666tong666/kuang/230/helmet_project/K230部署指南.md

# K230 部署指南 — YOLOv8 安全帽检测（CanMV IDE 版）

> 模型：`runs/helmet_yolov8n/weights/best.pt` (val mAP50=0.957, R=0.911, P=0.931, 3M 参数)
> 板端：Yahboom K230（CanMV micropython V1.4.3-3）
> 工具链：nncase 2.10.0 (KPU target) + Python 3.13 venv（`C:\Users\17244\.workbuddy\binaries\python\envs\default`）

---

## 1. 链路总览（全部已完成 ✅）

```
best.pt ──export_onnx.py──► best.onnx ──compile_kmodel.py──► helmet_yolov8n_uint8.kmodel
（已验证）                  (opset12, 1x3x640x640)           (3.5MB, PTQ uint8, NCHW 输入)
                                                                    │
                                                    拷到 SD 卡 /sdcard/ │
                                                                    ▼
                                              CanMV IDE 打开 helmet_inference.py
                                              点 ▶ 运行 → 实时检测（绿框=戴帽 红框=未戴）
```

PC 模拟验证已通过：6 张图 23 框，置信度 0.73~0.88，与 ONNX 基准一致（`verification/kmodel_sim/`）。

---

## 2. 你要做的事（CanMV IDE 用户，3 步）

### ① 拷 kmodel 到板子
任选其一：
- **U 盘方式（推荐）**：Type-C 线连板子和电脑 → 电脑出现 `CanMV` U 盘 → 把
  `D:\230\helmet_project\runs\helmet_yolov8n\kmodel\helmet_yolov8n_uint8.kmodel`
  拖进 U 盘（对应板端 `/sdcard/`）
- **读卡器方式**：拔 SD 卡插读卡器，把 kmodel 拷到卡根目录，插回板子

### ② CanMV IDE 打开脚本运行
1. 打开 CanMV IDE，左下角**连接**板子（选对应 COM 口）
2. 打开本地文件 `D:\230\helmet_project\helmet_inference.py`
3. 点左下角**绿色 ▶ 运行**
4. 看 IDE 右侧/上方**帧缓冲**面板：实时画面 + 检测框

### ③ 看效果
- 绿框 `helmet 0.xx` = 戴安全帽
- 红框 `head 0.xx` = 未戴帽
- 左上角 `helmet:N head:N fps:N` 实时统计
- 红色 ■ 停止

**没接屏幕？** 脚本默认 `DISPLAY_MODE="virt"`（只在 IDE 里预览），无需任何屏幕。
接了配套 MIPI 屏（ST7701 800×480）就改成 `"lcd"`；HDMI 屏改 `"hdmi"`。

---

## 2.5 串口输出人数（TTL 转 USB）

`helmet_inference.py` 已内置串口输出，每帧发一行（115200, 8N1）：

```
helmet:2,head:1\r\n     ← 戴帽人数 / 未戴帽人数
```

### 接线（3 根线，断电接）

| TTL 转 USB 模块 | K230 板 |
|---|---|
| RX | 板子 UART TX（TXD） |
| TX | 板子 UART RX（只发不收可不接） |
| GND | GND（**必须共地**） |
| VCC/5V | **不接** |

- 模块若有 5V/3.3V 跳线，选 **3.3V**；官方文档警告禁用劣质 CH340G 黄跳帽模块（可能烧 IO）
- 亚博板有专用串口排座的话直接用配套 PH2.0 线；脚本会**自动优先用亚博固件的
  `ybUtils.YbUart`**（自动处理引脚映射），找不到该库才回退 FPIOA 映射
  UART1（默认 pin11=TX / pin12=RX，可在脚本顶部 `UART_TX_PIN/UART_RX_PIN` 改）
- 引脚位置不确定时：跑一下脚本看启动日志 `[uart] ...` 用了哪种方式；或跑亚博官方
  「串口通信」基础例程看它用的引脚，把 `UART_TX_PIN/UART_RX_PIN` 改成一样的

### PC 端看数据（两种方式任选）

1. **串口助手**（SSCOM/XCOM 等）：选 TTL 模块的 COM 口，115200-8-N-1，ASCII 显示
2. **本项目脚本**（会实时打印每行人数）：
   ```bash
   D:/230/venv2/Scripts/python.exe uart_reader.py --list   # 插上模块后找新 COM 口
   D:/230/venv2/Scripts/python.exe uart_reader.py COM7     # 115200 默认
   ```

### 可调参数（脚本顶部配置区）

| 参数 | 默认 | 说明 |
|---|---|---|
| `UART_ENABLE` | `True` | 关掉串口输出 |
| `UART_BAUDRATE` | `115200` | 与 PC 端一致 |
| `UART_SEND_EVERY_FRAME` | `True` | `False`=人数变化时才发（串口更安静） |

### 接 STM32 主控（正式部署，替代 TTL 转 USB）

K230 的串口输出可直接接入主工程 `kuan/`（STM32F407VET6）的 **UART4**，
STM32 在接收中断里解析人数，随环境数据一起经蓝牙/MQTT 上报小程序：

| K230 板 | STM32F407VET6 | 说明 |
|---|---|---|
| UART TX（pin11 / TXD 排针） | **PC11**（UART4_RX） | 人数数据 K230 → STM32 |
| UART RX（pin12 / RXD 排针） | **PC10**（UART4_TX） | 只收不发可不接 |
| GND | GND | **必须共地** |

- 两侧都是 **3.3V 电平**，可直连，无需电平转换；
- STM32 侧固件已实现（`kuan/Driver/USART.c` 的 `UART4_Config` + 接收中断解析），
  K230 掉线超 5 秒 OLED 第 4 行右侧显示 `H:-U:-`；
- 上报格式见 `xiaocehngx/docs/STM32数据上报协议.md` v2.1（`helmet`/`head` 字段）。

---

## 3. 板端脚本说明（helmet_inference.py）

与嘉楠官方 yolov8n 检测示例完全同构（V1.4.x media API）：

- sensor 双通道：chn0 YUV420 绑显示层（AI 慢不卡预览），chn1 RGB888P(=NCHW) 给 AI
- ai2d 做 letterbox（等比缩放 + 右/下 pad 128）→ 640×640 NCHW uint8
- kmodel 内已烧入归一化（uint8→0~1），板端无需再算
- 后处理：阈值过滤 → **分类别 NMS**（helmet/head 互不抑制）→ 画框
- 输出 `[1,6,8400]`：4 框参数 + helmet/head 两类 sigmoid 分数

可调参数（脚本顶部配置区）：

| 参数 | 当前值 | 说明 |
|---|---|---|
| `DISPLAY_MODE` | `"virt"` | IDE 预览 / `"lcd"` / `"hdmi"` |
| `CONF_THRESH` | 0.30 | 怕漏检降到 0.25 |
| `NMS_THRESH` | 0.45 | YOLO 标配 |
| `LABELS` | `("helmet","head")` | **必须与训练 data.yaml 一致，勿改顺序** |

---

## 4. 如需重新编译 kmodel（换板型 / 重训后）

```bash
cd D:\230\helmet_project

# 校准集（已有 calib_data/ 可跳过）
"C:/Users/17244/.workbuddy/binaries/python/envs/default/Scripts/python.exe" ptq_calib.py --n 32

# 编译（K230；板型若是 K230D 加 --target k230d）
DOTNET_ROLL_FORWARD=Major "C:/Users/17244/.workbuddy/binaries/python/envs/default/Scripts/python.exe" \
  compile_kmodel.py --ptq calib_data --preprocess --input_shape 1,3,640,640 --input_layout NCHW

# PC 模拟质检（编译后必跑）
DOTNET_ROLL_FORWARD=Major "C:/Users/17244/.workbuddy/binaries/python/envs/default/Scripts/python.exe" \
  verify_kmodel.py
```

> **注意**：`--input_shape 1,3,640,640 --input_layout NCHW` 是板端部署的正确姿势
> （sensor RGBP888 + ai2d 输出就是 NCHW）。NHWC 版仅 PC 调试用。

## 5. 板型确认（K230 vs K230D）

CanMV IDE 连接后，在串口终端（REPL）执行：

```python
import chip
print(chip.name())
```

- 输出 `k230` → 当前 kmodel 直接用
- 输出 `k230d` → 用 `--target k230d` 重编（见上节）
- 报错没有 `chip` 模块 → 看板子丝印/说明书确认

---

## 6. 关键参数 / 经验值

| 参数 | 训练 | K230 部署 | 说明 |
|---|---|---|---|
| input shape | 640×640 | 640×640 | 静态输入，KPU 效率高 |
| input layout | NCHW float32 | **NCHW uint8**（preprocess=True） | 归一化烧进 kmodel |
| conf threshold | val 0.001 | **0.30**（可 0.25） | 安全帽宁可误报不能漏报 |
| NMS IoU | – | 0.45 | 分类别 NMS |
| labels | helmet=0, head=1 | 严格一致 | 反了"安全/危险"判断就反了 |

## 7. nncase 工具链踩坑记录（PC 侧）

| 坑 | 修复 |
|---|---|
| PyPI 的 nncase 不带 KPU 后端（`check_target('k230')=False`） | 用 kendryte 官方 wheel：`tools/nncase-2.10.0-*.whl` + `tools/nncase_kpu-2.10.0-*.whl`（手动解压覆盖到 site-packages） |
| nncase 硬绑 .NET 7，系统只有 .NET 8+ | 运行前设 `DOTNET_ROLL_FORWARD=Major` |
| venv3 的 cv2/numpy 被装坏 | 校准图用 PIL；numpy 重装 |
| GitHub release 直连超时 | 用嘉楠国内 CDN：`https://download.kendryte.com/developer/tools/nncase/v2.10.0/`（curl 会被沙盒截断，用 PowerShell Invoke-WebRequest） |
| nncase Simulator 报 DLL 找不到 | 把 site-packages 根目录加进 `PATH` + 设 `NNCASE_PLUGIN_PATH` |
| 预处理除两次 255（分数全死 ~0.0007） | `input_range=[0,1]` 时 `std` 必须 `[1,1,1]` |
| 校准张量缺 batch 维 | 每个样本包成 `[array]`，shape `[1,3,640,640]` |

---

## 8. 故障排查（板端）

| 现象 | 原因 / 处理 |
|---|---|
| `找不到 kmodel` | kmodel 不在 `/sdcard/`；确认 U 盘拷贝完成（3.5MB） |
| `kpu.load_kmodel` 报版本/格式错误 | kmodel(2.10 编译) 与固件 nncase 运行时不匹配 → 报我，用 2.9 重编一版 |
| `No available sensor` | 摄像头没插好或不在默认 CSI 口；脚本会自动试 `Sensor(id=2)`，还不行检查排线 |
| `ImportError: media.sensor` | 固件过老，需 CanMV V1.4.x media API（你的 V1.4.3 没问题） |
| 画面黑 / 无预览 | `DISPLAY_MODE` 不对；无屏用 `"virt"` |
| 画面上下颠倒 | 取消脚本里 `sensor.set_hmirror / set_vflip` 注释 |
| FPS 很低（<3） | 正常范围：640×640 uint8 在 K230 约 5~10 FPS；要更快用 320×320 重训 |
| 检测框位置飘 | 摄像头分辨率与 AI_W/AI_H 不符；或 `ratio` 相关参数被改动 |
| 长时间运行内存溢出 | 脚本已每帧 `gc.collect()`；仍出现则重启板子 |

---

## 9. 文件清单

| 文件 | 作用 |
|---|---|
| `runs/helmet_yolov8n/kmodel/helmet_yolov8n_uint8.kmodel` | **部署产物**（3.5MB，拷 SD 卡） |
| `helmet_inference.py` | 板端推理脚本（CanMV IDE 直跑，含串口人数输出） |
| `uart_reader.py` | PC 端读取串口人数（需 pyserial，venv2 已装） |
| `compile_kmodel.py` | ONNX → kmodel 编译（NCHW/NHWC 双模式） |
| `verify_kmodel.py` | PC 模拟质检 kmodel（喂 NCHW uint8） |
| `ptq_calib.py` | PTQ 校准集生成 |
| `export_onnx.py` | best.pt → best.onnx |
| `verification/kmodel_sim/` | kmodel 模拟验证结果图 |
| `tools/*.whl` | kendryte 官方 nncase wheel 备份 |
