666tong666/kuang/230/helmet_project/训练报告.md

# 安全帽检测 YOLOv8n 模型训练报告

## 任务
用 YOLOv8 训练一个轻量化模型，检测人员是否佩戴安全帽。

## 环境
- Python: D:\230\venv2 (Python 3.10.10)
- torch 2.3.0+cu121, ultralytics 8.4.105
- GPU: NVIDIA GeForce RTX 3060 Laptop (6GB)

## 数据集
- 来源: Kaggle `andrewmvd/hard-hat-detection`（Hard Hat Workers，工地场景）
- 5000 张图，VOC 标注转换为 YOLO 格式
- 划分: train 4250 / val 750
- 类别: 0=helmet(戴安全帽, 18966 框), 1=head(未戴, 5785 框)

## 训练配置
- 模型: YOLOv8n（300 万参数, 8.1 GFLOPs, 权重仅 6MB — 轻量化）
- epochs=60, imgsz=640, batch=16, GPU 训练 1.4 小时

## 最终验证指标（best.pt, 750 张验证集）
| 类别 | P | R | mAP50 | mAP50-95 |
|---|---|---|---|---|
| 全部 | 0.933 | 0.911 | **0.956** | 0.631 |
| helmet 戴帽 | 0.946 | 0.920 | 0.967 | 0.637 |
| head 未戴 | 0.915 | 0.903 | 0.944 | 0.624 |

- 推理速度: ~4.7ms/张 (GPU)

## 文件位置（D:\230\helmet_project\）
- `runs/helmet_yolov8n/weights/best.pt` — 最佳模型权重
- `runs/helmet_yolov8n/results.png` — 训练曲线
- `runs/helmet_yolov8n/confusion_matrix_normalized.png` — 混淆矩阵
- `demo/pred/image0-3.jpg` — 推理演示效果图
- `train.py` / `predict.py` / `data.yaml` / `convert_voc_to_yolo.py` — 全套脚本

## 使用方法
```bash
# 图片/视频/摄像头推理
D:/230/venv2/Scripts/python.exe predict.py --source 图片路径
# 摄像头: --source 0
```
