666tong666/kuang/230/helmet_project/demo/pred/image2.jpg

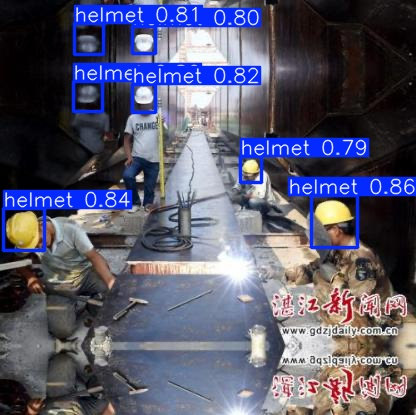
230/helmet_project/demo/pred/image2.jpg
