666tong666/kuang/230/helmet_project/runs/detect/val/BoxPR_curve.png

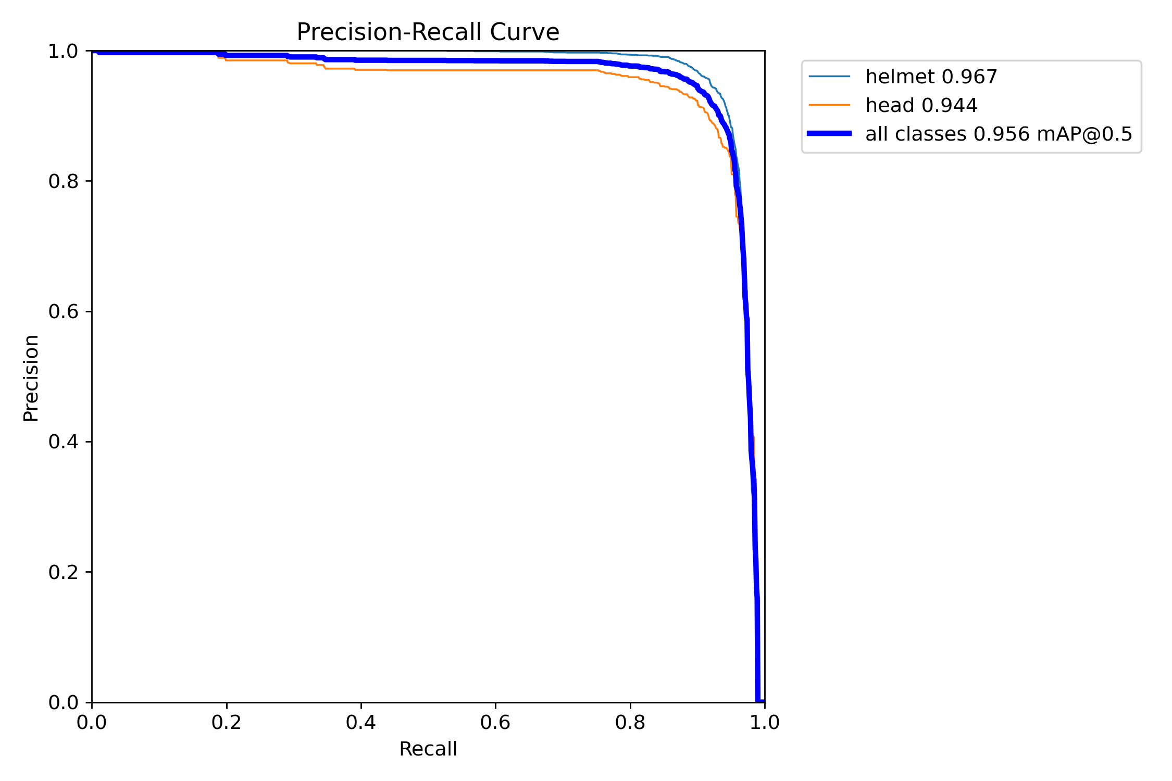
230/helmet_project/runs/detect/val/BoxPR_curve.png
