666tong666/kuang/230/helmet_project/runs/detect/val/BoxR_curve.png

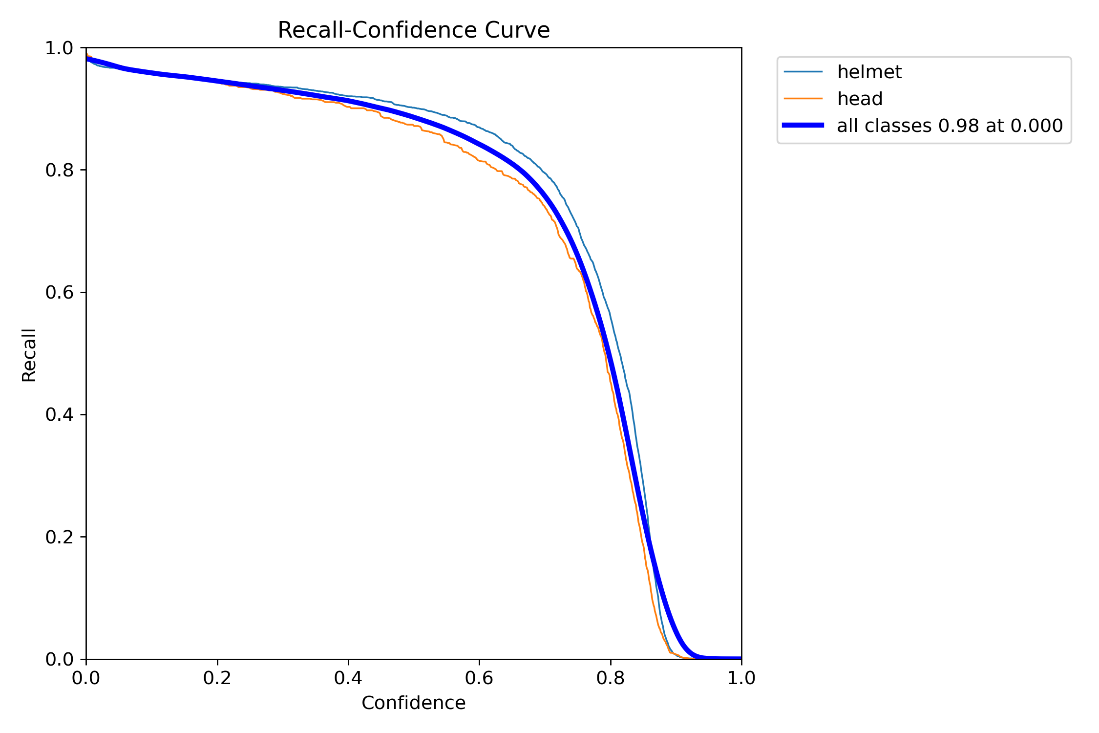
230/helmet_project/runs/detect/val/BoxR_curve.png
