666tong666/kuang/230/helmet_project/runs/detect/val/confusion_matrix.png

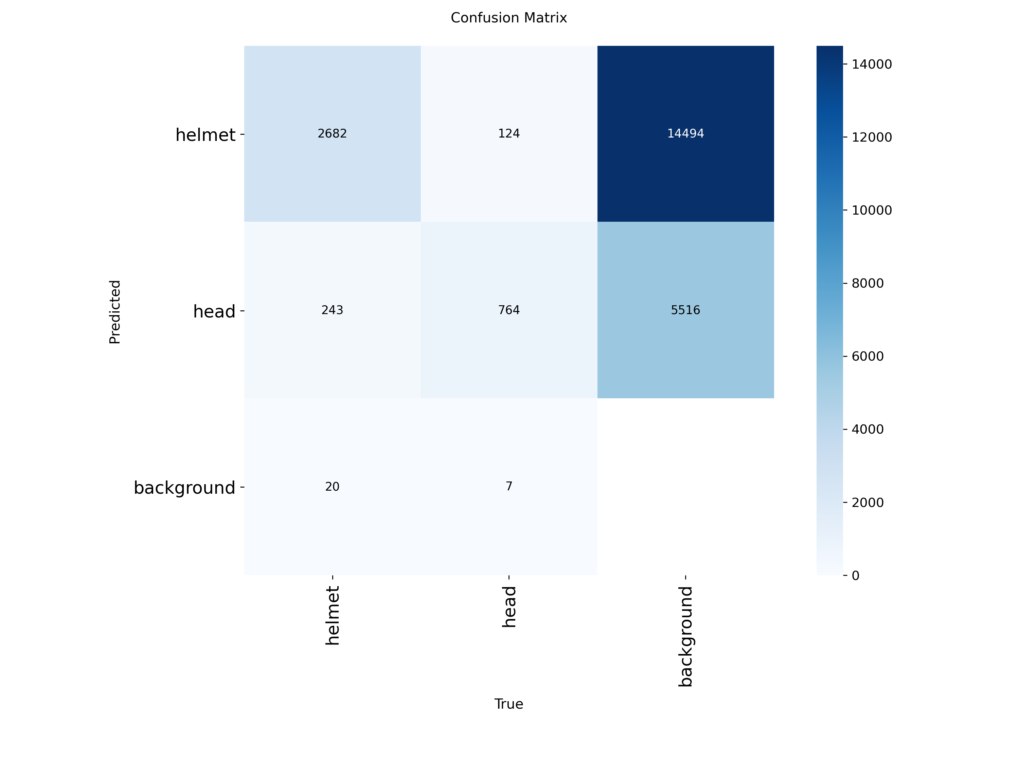
230/helmet_project/runs/detect/val/confusion_matrix.png
