666tong666/kuang/230/helmet_project/runs/detect/val/confusion_matrix_normalized.png

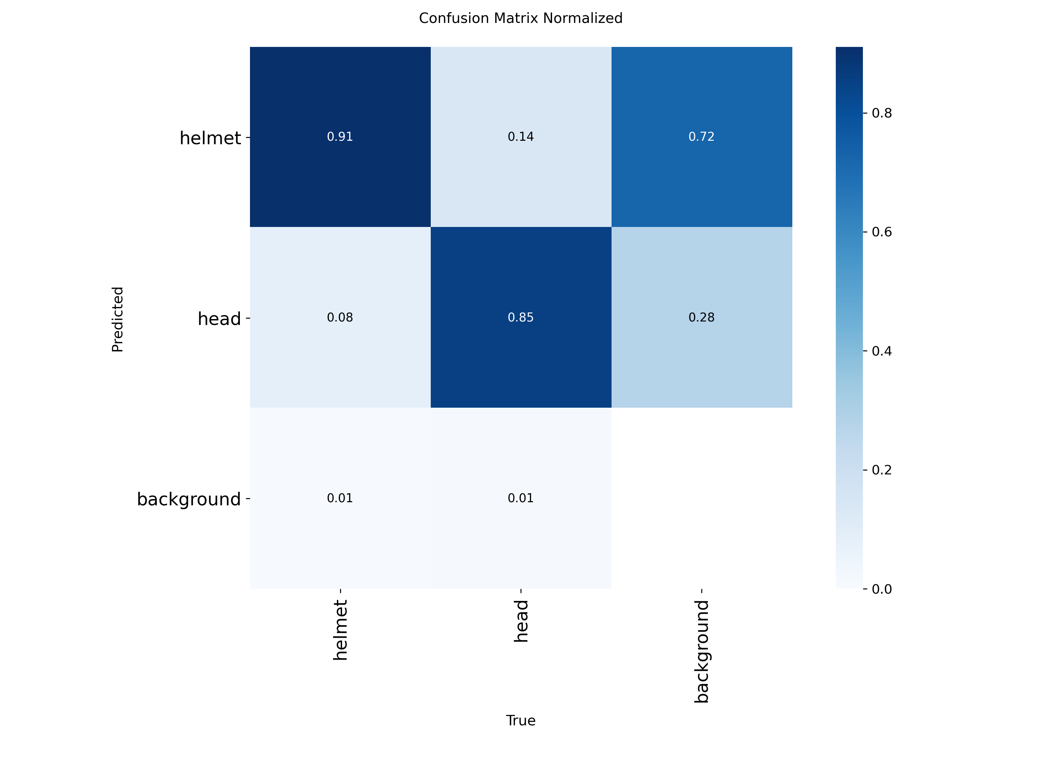
230/helmet_project/runs/detect/val/confusion_matrix_normalized.png
