666tong666/kuang/230/helmet_project/runs/detect/val/val_batch1_labels.jpg

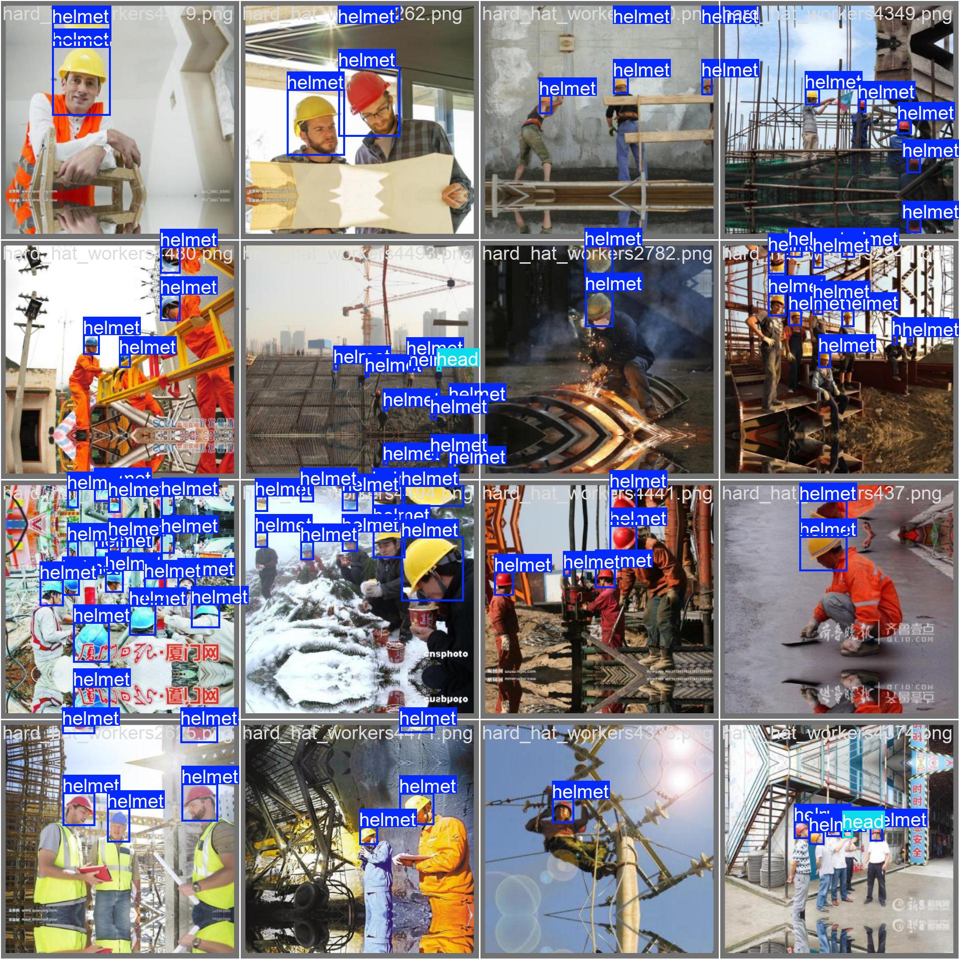
230/helmet_project/runs/detect/val/val_batch1_labels.jpg
