666tong666/kuang/230/helmet_project/runs/helmet_yolov8n/train_batch0.jpg

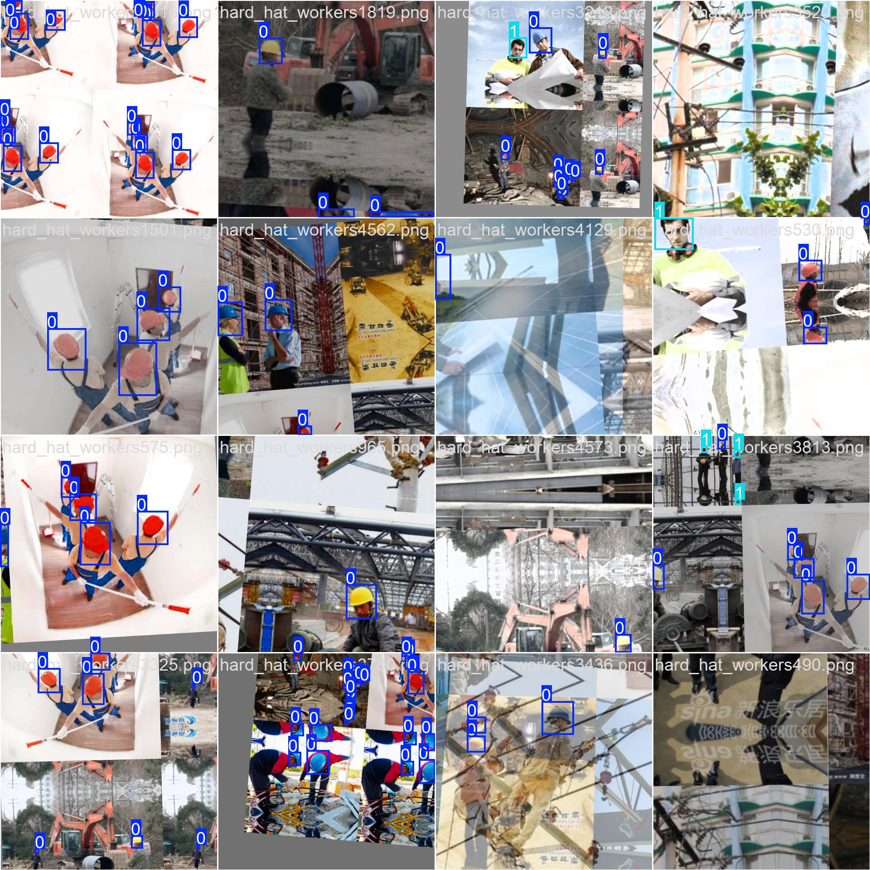
230/helmet_project/runs/helmet_yolov8n/train_batch0.jpg
