666tong666/kuang/230/helmet_project/runs/helmet_yolov8n/val_batch2_labels.jpg

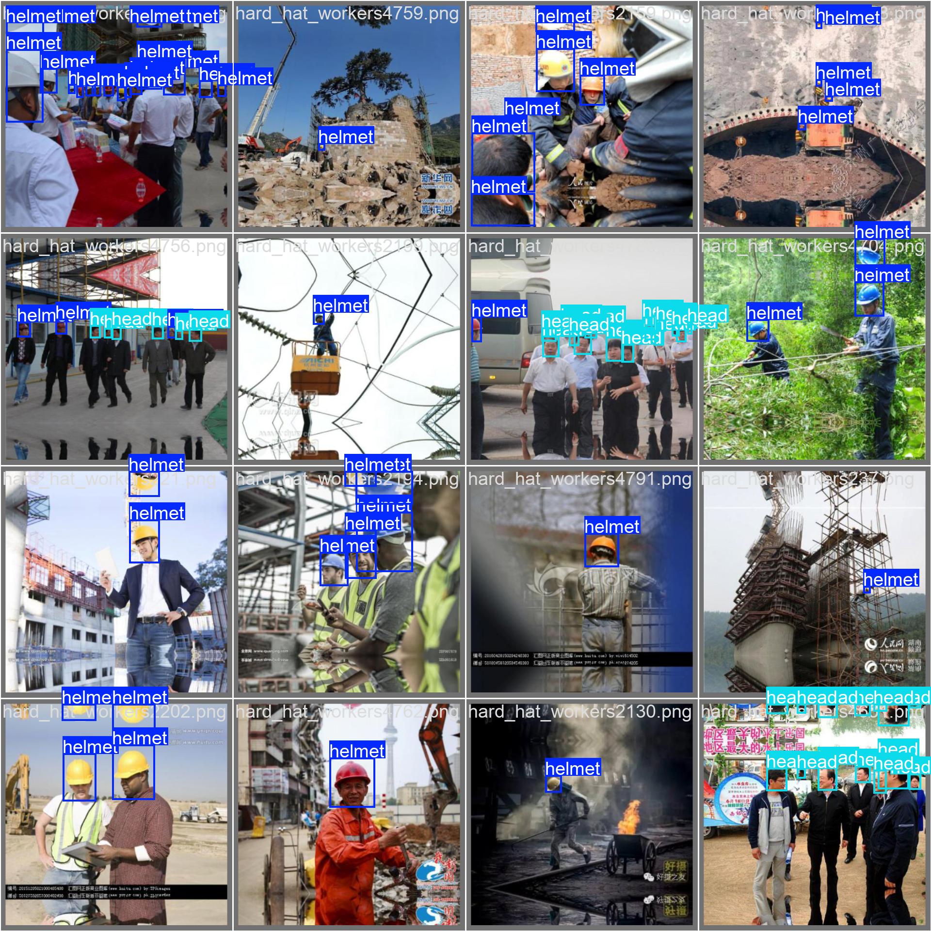
230/helmet_project/runs/helmet_yolov8n/val_batch2_labels.jpg
