666tong666/kuang/230/helmet_project/runs/helmet_yolov8n/results.csv

epoch | time | train/box_loss | train/cls_loss | train/dfl_loss | metrics/precision(B) | metrics/recall(B) | metrics/mAP50(B) | metrics/mAP50-95(B) | val/box_loss | val/cls_loss | val/dfl_loss | lr/pg0 | lr/pg1 | lr/pg2
1 | 76.0567 | 1.54549 | 1.73085 | 1.21669 | 0.79775 | 0.75106 | 0.81882 | 0.44803 | 1.58454 | 1.26902 | 1.20523 | 0.000553578 | 0.000553578 | 0.000553578
2 | 148.469 | 1.46355 | 1.15994 | 1.1817 | 0.85742 | 0.76154 | 0.84935 | 0.46724 | 1.53768 | 1.00888 | 1.22156 | 0.00110849 | 0.00110849 | 0.00110849
3 | 221.656 | 1.45243 | 1.08636 | 1.18802 | 0.87461 | 0.77395 | 0.8562 | 0.49053 | 1.49899 | 0.93901 | 1.19897 | 0.0016604 | 0.0016604 | 0.0016604
4 | 295.723 | 1.44735 | 1.03532 | 1.18671 | 0.85031 | 0.79694 | 0.87373 | 0.52562 | 1.39922 | 0.88641 | 1.17073 | 0.00165684 | 0.00165684 | 0.00165684
5 | 370.674 | 1.41338 | 0.98015 | 1.17673 | 0.87991 | 0.82172 | 0.89244 | 0.52359 | 1.45622 | 0.83131 | 1.19142 | 0.00164897 | 0.00164897 | 0.00164897
6 | 458.325 | 1.40912 | 0.94933 | 1.16853 | 0.88605 | 0.83586 | 0.90974 | 0.52517 | 1.46586 | 0.77827 | 1.18659 | 0.00163888 | 0.00163888 | 0.00163888
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
