666tong666/kuang/230/helmet_project/runs/helmet_yolov8n/results.png

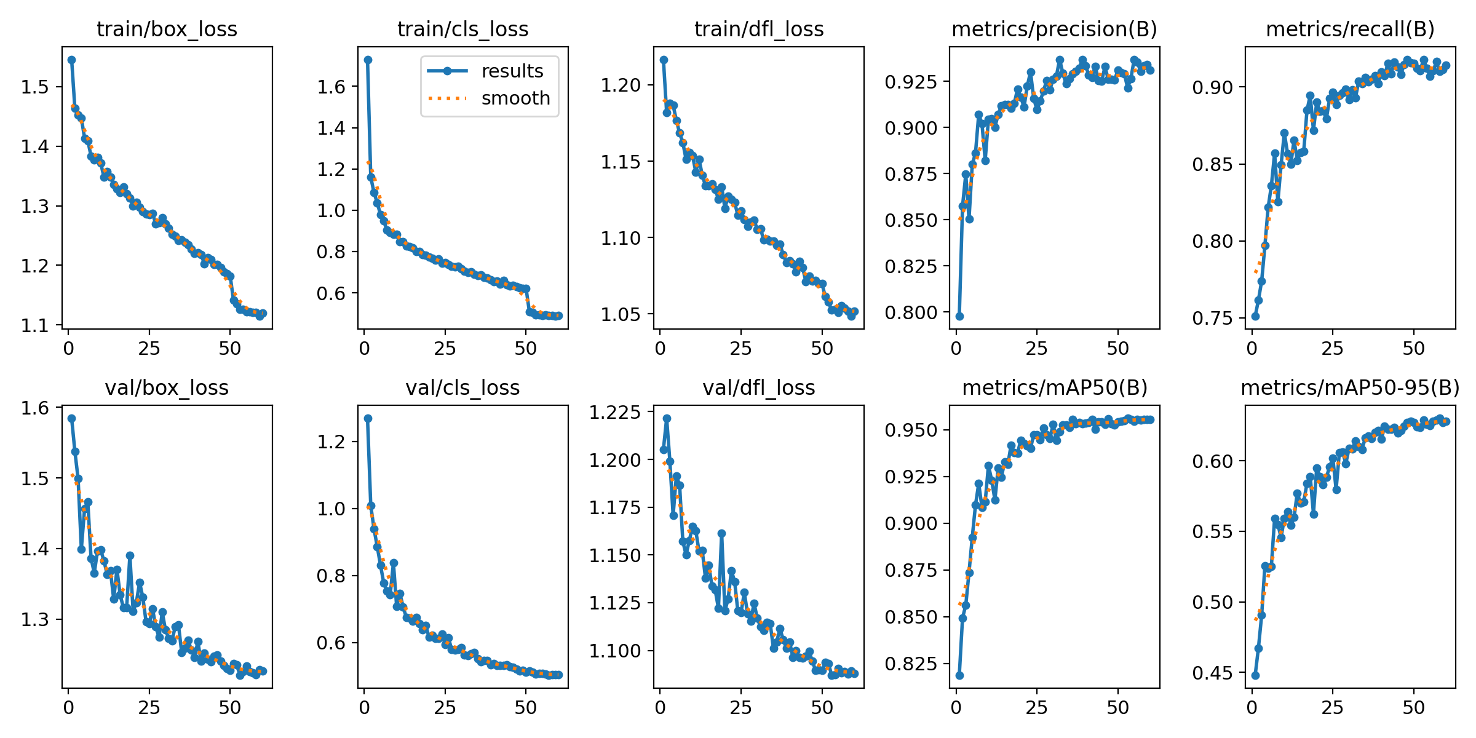
230/helmet_project/runs/helmet_yolov8n/results.png
