666tong666/kuang/230/helmet_project/verification/kmodel_sim/hard_hat_workers1222.png

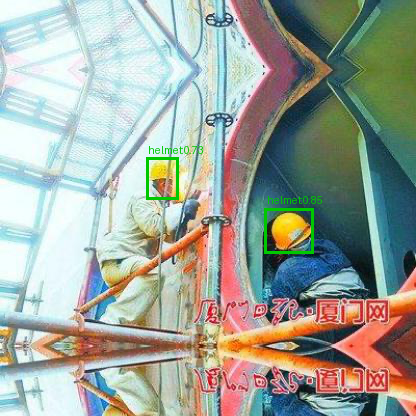
230/helmet_project/verification/kmodel_sim/hard_hat_workers1222.png
