666tong666/kuang/230/helmet_project/verification/kmodel_sim/hard_hat_workers1283.png

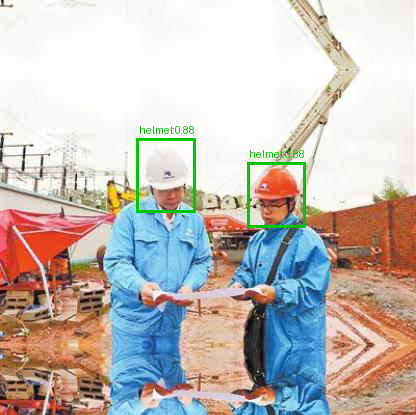
230/helmet_project/verification/kmodel_sim/hard_hat_workers1283.png
