666tong666/kuang/230/helmet_project/verification/kmodel_sim/hard_hat_workers1760.png

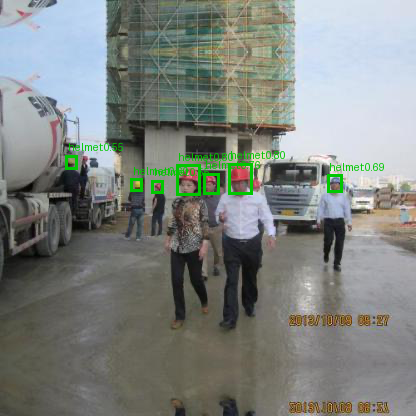
230/helmet_project/verification/kmodel_sim/hard_hat_workers1760.png
