666tong666/kuang/230/helmet_project/verification/samples/hard_hat_workers2564.png

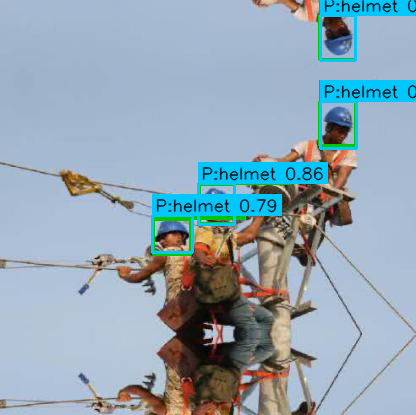
230/helmet_project/verification/samples/hard_hat_workers2564.png
