666tong666/kuang/kuan/Driver/oledfont_cn.h

/* ============================================================
 * oledfont_cn.h  -- 16x16 中文字库 (与 oledfont.h ASCII 共存)
 * 取模方向：列扫描 + bit0=顶，与 oledfont.h ASCII 完全一致
 * 字节布局：byte[0..15] = 上半 page (行 0..7)
 *           byte[16..31] = 下半 page (行 8..15)
 * 取模工具：kuan/tools/gen_cn_font.py (Windows GDI)
 * ============================================================ */
#ifndef __OLED_FONT_CN_H
#define __OLED_FONT_CN_H
#include "stm32f4xx.h"

/* 中文字库下标（不要插队；只在末尾追加新字） */
#define OLED_CN_COUNT 44

/* 字模表 [index] = { gbkh, gbkl, 32 字节点阵... } */
const uint8_t OLED_CN16x16[][34] = {
    /*  0  '温'  GBK:0xCEC2 */
    { 0xCE, 0xC2,
    0x10, 0x60, 0x02, 0x8C, 0x00, 0x00, 0xFE, 0x92,
    0x92, 0x92, 0x92, 0x92, 0xFE, 0x00, 0x00, 0x00,
    0x04, 0x04, 0x7E, 0x01, 0x40, 0x7E, 0x42, 0x42,
    0x7E, 0x42, 0x7E, 0x42, 0x42, 0x7E, 0x40, 0x00,
    },
    /*  1  '湿'  GBK:0xCAAA */
    { 0xCA, 0xAA,
    0x10, 0x60, 0x02, 0x8C, 0x00, 0xFE, 0x92, 0x92,
    0x92, 0x92, 0x92, 0x92, 0xFE, 0x00, 0x00, 0x00,
    0x04, 0x04, 0x7E, 0x01, 0x44, 0x48, 0x50, 0x7F,
    0x40, 0x40, 0x7F, 0x50, 0x48, 0x44, 0x40, 0x00,
    },
    /*  2  '度'  GBK:0xB6C8 */
    { 0xB6, 0xC8,
    0x00, 0x00, 0xFC, 0x24, 0x24, 0x24, 0xFC, 0x25,
    0x26, 0x24, 0xFC, 0x24, 0x24, 0x24, 0x04, 0x00,
    0x40, 0x30, 0x8F, 0x80, 0x84, 0x4C, 0x55, 0x25,
    0x25, 0x25, 0x55, 0x4C, 0x80, 0x80, 0x80, 0x00,
    },
    /*  3  '气'  GBK:0xC6F8 */
    { 0xC6, 0xF8,
    0x20, 0x10, 0x4C, 0x47, 0x54, 0x54, 0x54, 0x54,
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
    0x02, 0x02, 0x02, 0x02, 0x04, 0x1E, 0x00, 0x00,
    0x00, 0x00, 0x00, 0x07, 0x1F, 0x30, 0x20, 0x40,
    0x40, 0x40, 0x40, 0x40, 0x20, 0x10, 0x00, 0x00,
    },
    /* 43  '×'  GBK:0xA1C1 */
    { 0xA1, 0xC1,
    0x00, 0x00, 0x00, 0x08, 0x10, 0x20, 0x40, 0x80,
    0x40, 0x20, 0x10, 0x08, 0x00, 0x00, 0x00, 0x00,
    0x00, 0x00, 0x00, 0x08, 0x04, 0x02, 0x01, 0x00,
    0x01, 0x02, 0x04, 0x08, 0x00, 0x00, 0x00, 0x00,
    },
};

/* === 索引表（顺序 = OLED_CN16x16 下标；与上方数组一一对应） ===
 *  0:温  1:度  2:湿  3:气  4:体  5:浓  6:震  7:动
 *  8:状  9:态 10:报 11:警 12:正 13:常 14:阈 15:值
 * 16:设 17:置 18:当 19:前 20:记 21:录 22:测 23:试
 * 24:井 25:下 26:监 27:测 28:蓝 29:牙 30:华 31:为
 * 32:云 33:端 34:连 35:接 36:欢 37:迎 38:初 39:始
 * 40:化 41:℃ 42:×
 */

#endif /* __OLED_FONT_CN_H */
