666tong666/kuang/kuan/Driver/light_adc.c

#include "light_adc.h"
/* 光照度 */
uint16_t LUX;

/* GL5516光敏电阻的阻值与流明对应表 */
const PhotoRes_TypeDef GL5516[281] =
	{
		{40000, 1},
		{26350, 2},
		{20640, 3},
		{17360, 4},
		{15170, 5},
		{13590, 6},
		{12390, 7},
		{11430, 8},
		{10650, 9},
		{9990, 10},
		{9440, 11},
		{8950, 12},
		{8530, 13},
		{8160, 14},
		{7830, 15},
		{7530, 16},
		{7260, 17},
		{7010, 18},
		{6790, 19},
		{6580, 20},
		{6390, 21},
		{6210, 22},
		{6050, 23},
		{5900, 24},
		{5750, 25},
		{5620, 26},
		{5490, 27},
		{5370, 28},
		{5260, 29},
		{5160, 30},
		{5050, 31},
		{4960, 32},
		{4870, 33},
		{4780, 34},
		{4700, 35},
		{4620, 36},
		{4540, 37},
		{4470, 38},
		{4400, 39},
		{4330, 40},
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
};

/**
 * @brief  获取光照度函数
 * @param  PhotoResistor：光敏电阻电阻值
 * @retval 获取到的光照度
 */
uint16_t GetLux(float PhotoResistor)
{
	int i = 0;
	uint16_t lux = 0;

	/* 查表法，对比281个参照数据，根据电阻值得出光照度 */
	for (i = 0; i < 281; i++)
	{
		/* 获取的电阻与列表最小电阻进行比较 */
		if (PhotoResistor < 620)
		{
			lux = 1000;
			break;
		}
		else if (PhotoResistor > GL5516[i].ohm)
		{
			lux = GL5516[i].lux;
			break;
		}
	}

	return lux;
}
