666tong666/kuang/kuan/Driver/mq135.c

#include "mq135.h"

/* 等待转换完成并读取 (RTOS版: 带超时上限)
 * ADC1 是单例外设, startup 与 sensor 两个任务都会触发转换:
 * 对方读 DR 会清掉 EOC, 无超时等待会永久卡死 —— 超时后按无效值处理 */
#define MQ135_EOC_GUARD  50000u

static uint16_t MQ135_WaitEOC_Read(void)
{
    uint32_t guard = 0;

    while(ADC_GetFlagStatus(ADC1, ADC_FLAG_EOC) == RESET)
    {
        if(++guard > MQ135_EOC_GUARD) return 0u;   /* 超时: 本次按0处理 */
    }
    return ADC_GetConversionValue(ADC1);
}

void ADC_MQ135_Init(void)
{
	GPIO_InitTypeDef GPIO_InitStruct;
	ADC_InitTypeDef ADC_InitStruct;
	ADC_CommonInitTypeDef ADC_CommonInitStruct;

	//1.开启GPIOA、ADC1时钟
	RCC_AHB1PeriphClockCmd(RCC_AHB1Periph_GPIOA, ENABLE);
	RCC_APB2PeriphClockCmd(RCC_APB2Periph_ADC1, ENABLE);

	//2.PA4设置为模拟输入，关闭DAC，防止引脚复用冲突
	GPIO_InitStruct.GPIO_Pin = GPIO_Pin_4;
	GPIO_InitStruct.GPIO_Mode = GPIO_Mode_AN;
	GPIO_InitStruct.GPIO_PuPd = GPIO_PuPd_NOPULL;
	GPIO_Init(GPIOA, &GPIO_InitStruct);

	RCC_APB1PeriphClockCmd(RCC_APB1Periph_DAC, DISABLE); //关闭DAC，PA4复用DAC1_OUT

	//3.ADC通用配置（独立模式）
	ADC_CommonInitStruct.ADC_Mode = ADC_Mode_Independent;
	ADC_CommonInitStruct.ADC_Prescaler = ADC_Prescaler_Div4;
	ADC_CommonInitStruct.ADC_DMAAccessMode = ADC_DMAAccessMode_Disabled;
	ADC_CommonInitStruct.ADC_TwoSamplingDelay = ADC_TwoSamplingDelay_5Cycles;
	ADC_CommonInit(&ADC_CommonInitStruct);

	//4.ADC1参数
	ADC_InitStruct.ADC_Resolution = ADC_Resolution_12b;
	ADC_InitStruct.ADC_ScanConvMode = DISABLE;
	ADC_InitStruct.ADC_ContinuousConvMode = DISABLE;
	ADC_InitStruct.ADC_ExternalTrigConvEdge = ADC_ExternalTrigConvEdge_None;
	ADC_InitStruct.ADC_DataAlign = ADC_DataAlign_Right;
	ADC_InitStruct.ADC_NbrOfConversion = 1;
	ADC_Init(ADC1, &ADC_InitStruct);

	//5.配置ADC通道4（PA4=ADC1_IN4），采样时间长一点抗干扰
	ADC_RegularChannelConfig(ADC1, ADC_Channel_4, 1, ADC_SampleTime_480Cycles);

	//6.开启ADC1
	ADC_Cmd(ADC1, ENABLE);
}

//读取一次ADC值，返回0~4095
//读取一次ADC值，自动适配并修正左对齐问题
uint16_t MQ135_Get_ADC(void)
{
    uint16_t val;
    ADC_SoftwareStartConv(ADC1);        //软件触发转换
    val = MQ135_WaitEOC_Read();         //等待转换完成并读取(带超时)

    // 如果 ADC 的对齐方式被其他外设改成了左对齐（数值>4095），自动右移恢复正常 12 位
    if(val > 4095)
    {
        val = val >> 4;
    }

    return val;
}

//n次采样取平均，滤除ADC随机噪声（n建议8~32）
//注意: 与MQ135_Get_ADC一样带">4095自动右移"兼容——本板上ADC1实际以
//左对齐出数(原始值最大65520), 不修正会算出负Rs -> ppm顶格9999
uint16_t MQ135_Get_ADC_Avg(uint8_t n)
{
    uint32_t sum = 0;
    uint8_t i;

    if(n == 0) n = 1;
    for(i = 0; i < n; i++)
    {
        uint16_t val;
        ADC_SoftwareStartConv(ADC1);
        val = MQ135_WaitEOC_Read();     /* 带超时, 防双任务竞争EOC死等 */
        if(val > 4095)           /* 左对齐兼容: 右移4位还原12位 */
        {
            val >>= 4;
        }
        sum += val;
    }
    return (uint16_t)(sum / n);
}
