666tong666/kuang/kuan/Driver/KEY.h

#ifndef __KEY_H
#define __KEY_H

#include "stm32f4xx.h"
void KEY_Config(void);

#define KEY_GROUP GPIOG

#define KEY0  GPIO_Pin_2

#define KEY1  GPIO_Pin_3

#define KEY2  GPIO_Pin_4

#define KEY3  GPIO_Pin_5

#endif
