666tong666/kuang/(commit log)

2026-09-09 初始提交：井下环境监测系统（STM32固件 + 微信小程序 + K230安全帽检测 + BT24蓝牙测试）
    [results.csv]
2026-09-09 K230安全帽数据接入STM32：UART4(PC10/PC11)接收解析人数，随蓝牙/MQTT上报小程序（协议v2.1新增helmet/head字段）
2026-09-09 忽略Keil命令行编译日志文件
2026-09-09 修复MQ135一直9999：上电改为等读数稳定再校准R0（60~300s自适应），新增基线合法性检查与接线错误诊断
2026-09-09 修复MQ135读数9999根因：MQ135_Get_ADC_Avg缺左对齐兼容补丁，裸读>4095导致Rs为负、ppm顶格；与MQ135_Get_ADC对齐处理
2026-09-09 MQ135预热改为固定120s+6.4s长窗口校准：原漂移稳定判据被±10%噪声反复打断，最长要等300s且不可预期
2026-09-09 小程序华为云通道补上K230安全帽数据：设备影子解析增加helmet/head字段透传（需在华为云产品模型中添加这两个属性）
2026-09-09 重写README：系统架构与数据链路流程图(Mermaid)、接线表、协议v2.1、快速上手、FAQ，附K230检测与小程序真机截图
2026-09-09 README配图适配：手机截图缩至420px宽并固定显示尺寸，两图均衡排版
2026-09-09 README新增应用界面演示图库：华为云通道告警联动/温度弹窗/震动弹窗/历史数据，按功能分类展示
2026-09-09 震动检测修复：新增上报粘性标志消除5s窗口漏报；阈值1400→4096(0.085g→0.25g)排除手碰/挪动/旋转误报
2026-09-09 震动阈值0.25g→0.5g：平放时桌面传导的冲击余振(<0.4g)不再误触发，直接摇晃/敲击仍可靠告警
2026-09-09 事件驱动上报：告警状态变化200ms内补发一帧，震动告警出现/恢复1~2秒内可见；震动锁存释放时清理粘性标志避免恢复被拖慢
2026-09-09 新增MPU6050串口诊断打印(MPU_DEBUG_PRINT开关)：每100ms原始值+超限差值+锁存/粘性状态，用于排查震动状态跳变
2026-09-10 新增数据传输格式与方向全景图：11条链路标注通道/格式/方向/频率+报文样例，README数据链路章节引用
2026-09-10 修正系统原理框图：感知层光敏电阻(系统未使用)替换为实际接入的K230视觉板(UART4安全帽人数检测)
2026-09-10 修复README系统架构图挂掉：中文文件名SVG在GitHub HTML img中不渲染，移至docs/images/data-flow-diagram.svg并用ASCII路径引用
2026-09-11 裸机前后台迁移至FreeRTOS V10.4.6：startup/sensor/report/blecmd/ui五任务架构，DWT延时替代SysTick，NVIC Group4+中断优先级约定；修复DHT11采样间隔与事务原子性(乱值/全0)、MQTT 30s保活探测+断线全量重连、震动确认窗对齐(3→5次)、printf并发与ADC双任务竞争两处卡死
    [DHT11.c, Delay.c, Delay.h, USART.c, app_tasks.c, app_tasks.h, esp8266.c]
2026-09-11 新增MQTT协议帧格式详解：CONNECT/SUBSCRIBE/PUBLISH/PINGREQ等九种报文按字节逐段拆解(本项目华为云接入真实值)
